Mercury-Avionics/Mercury/README.md

# Mercury
Integrated Avionics Package for Rocket and UAV Needs
Built on STM32 F4
