Mercury-Avionics/Mercury/hardware/parts/Parts-Pricelist.xlsx

Reference Designator | Value | Footprint | Part # (LCSC) | Unit Price | Function / Notes | Reference
C1 | 4.7u | 0805 | C1779 (https://lcsc.com/product-detail/Multilayer-Ceramic-Capacitors-MLCC-SMD-SMT_SAMSUNG_CL21A475KAQNNNE_4-7uF-475-10-25V_C1779.html/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) |  | Bulk Decoupling of STM32 | STM32F407 Datasheet 5.1.6
C2 | 100n | 0402 | C1525 (https://lcsc.com/product-detail/Multilayer-Ceramic-Capacitors-MLCC-SMD-SMT_SAMSUNG_CL05B104KO5NNNC_100nF-104-10-16V_C1525.html/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) |  | Bulk Decoupling of STM32 | STM32F407 Datasheet 5.1.6
C3 | 100n | 0402 | C1525 (https://lcsc.com/product-detail/Multilayer-Ceramic-Capacitors-MLCC-SMD-SMT_SAMSUNG_CL05B104KO5NNNC_100nF-104-10-16V_C1525.html/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) |  | Bulk Decoupling of STM32 | STM32F407 Datasheet 5.1.6
C4 | 100n | 0402 | C1525 |  | Bulk Decoupling of STM32 | STM32F407 Datasheet 5.1.6
C5 | 100n | 0402 | C1525 |  | Bulk Decoupling of STM32 | STM32F407 Datasheet 5.1.6
C6 | 100n | 0402 | C1525 |  | Bulk Decoupling of STM32 | STM32F407 Datasheet 5.1.6
C7 | 100n | 0402 | C1525 |  | Bulk Decoupling of STM32 | STM32F407 Datasheet 5.1.6
C8 | 100n | 0402 | C1525 |  | Bulk Decoupling of STM32 | STM32F407 Datasheet 5.1.6
C9 | 1u | 0402 | C52923 (https://lcsc.com/product-detail/Multilayer-Ceramic-Capacitors-MLCC-SMD-SMT_SAMSUNG_CL05A105KA5NQNC_1uF-105-10-25V_C52923.html/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) |  | VDDA Analog Filtering | LTSpice
C10 | 10n | 0402 | C15195 (https://lcsc.com/product-detail/Multilayer-Ceramic-Capacitors-MLCC-SMD-SMT_SAMSUNG_CL05B103KB5NNNC_10nF-103-10-50V_C15195.html/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) |  | VDDA Analog Filtering | LTSpice
C11 | 2.2u | 0603 | C23630 (https://lcsc.com/product-detail/Multilayer-Ceramic-Capacitors-MLCC-SMD-SMT_SAMSUNG_CL10A225KO8NNNC_2-2uF-225-10-16V_C23630.html/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) |  | Stabilization of main internal regulator | STM32F407 Datasheet 5.3.2
C12 | 2.2u | 0603 | C23630 (https://lcsc.com/product-detail/Multilayer-Ceramic-Capacitors-MLCC-SMD-SMT_SAMSUNG_CL10A225KO8NNNC_2-2uF-225-10-16V_C23630.html/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) |  | Stabilization of main internal regulator | STM32F407 Datasheet 5.3.2
C13 | 12p | 0402 | C1547 (https://lcsc.com/product-detail/Multilayer-Ceramic-Capacitors-MLCC-SMD-SMT_12pF-120-5-50V_C1547.html/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) |  | Crystal Load Capacitance | HSE 16MHz Datasheet
C14 | 12p | 0402 | C1547 (https://lcsc.com/product-detail/Multilayer-Ceramic-Capacitors-MLCC-SMD-SMT_12pF-120-5-50V_C1547.html/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) |  | Crystal Load Capacitance | HSE 16MHz Datasheet
C15 | 22u | 0805 | C45783 (https://lcsc.com/product-detail/Multilayer-Ceramic-Capacitors-MLCC-SMD-SMT_SAMSUNG_CL21A226MAQNNNE_22uF-226-20-25V_C45783.html/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) |  | Voltage Regulator I/O decoupling | AMS1117 Datasheet
C16 | 22u | 0805 | C45783 (https://lcsc.com/product-detail/Multilayer-Ceramic-Capacitors-MLCC-SMD-SMT_SAMSUNG_CL21A226MAQNNNE_22uF-226-20-25V_C45783.html/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) |  | Voltage Regulator I/O decoupling | AMS1117 Datasheet
C17 | 22u | 0805 | C45783 (https://lcsc.com/product-detail/Multilayer-Ceramic-Capacitors-MLCC-SMD-SMT_SAMSUNG_CL21A226MAQNNNE_22uF-226-20-25V_C45783.html/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) |  | Voltage Regulator I/O decoupling | AMS1117 Datasheet
C18 | 22u | 0805 | C45783 (https://lcsc.com/product-detail/Multilayer-Ceramic-Capacitors-MLCC-SMD-SMT_SAMSUNG_CL21A226MAQNNNE_22uF-226-20-25V_C45783.html/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) |  | Voltage Regulator I/O decoupling | AMS1117 Datasheet
C19 | 100n | 0402 | C1525 (https://lcsc.com/product-detail/Multilayer-Ceramic-Capacitors-MLCC-SMD-SMT_SAMSUNG_CL05B104KO5NNNC_100nF-104-10-16V_C1525.html/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) |  | IMU Decoupling | MPU-6050 Datasheet 7.3
C20 | 100n | 0402 | C1525 (https://lcsc.com/product-detail/Multilayer-Ceramic-Capacitors-MLCC-SMD-SMT_SAMSUNG_CL05B104KO5NNNC_100nF-104-10-16V_C1525.html/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) |  | IMU Decoupling | MPU-6050 Datasheet 7.3
C21 | 100n | 0402 | C1525 (https://lcsc.com/product-detail/Multilayer-Ceramic-Capacitors-MLCC-SMD-SMT_SAMSUNG_CL05B104KO5NNNC_100nF-104-10-16V_C1525.html/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) |  | Regulator Filter Capacitor | MPU-6050 Datasheet 7.3
C22 | 2.2n | 0603 | C1604 (https://lcsc.com/product-detail/Multilayer-Ceramic-Capacitors-MLCC-SMD-SMT_2-2nF-222-10-50V_C1604.html/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) |  | Charge Pump Capacitor | MPU-6050 Datasheet 7.3
C23 | 100n | 0402 | C1525 (https://lcsc.com/product-detail/Multilayer-Ceramic-Capacitors-MLCC-SMD-SMT_SAMSUNG_CL05B104KO5NNNC_100nF-104-10-16V_C1525.html/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) |  | Decoupling capacitor | Estimate
C24 | 100n | 0402 | C1525 (https://lcsc.com/product-detail/Multilayer-Ceramic-Capacitors-MLCC-SMD-SMT_SAMSUNG_CL05B104KO5NNNC_100nF-104-10-16V_C1525.html/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) |  | Decoupling capacitor | MPL3115A2 Datasheet
C25 | 10u | 0805 | C15850 (https://lcsc.com/product-detail/Multilayer-Ceramic-Capacitors-MLCC-SMD-SMT_SAMSUNG_CL21A106KAYNNNE_10uF-106-10-25V_C15850.html/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) |  | Decoupling capacitor | MPL3115A2 Datasheet
C26 | 100n | 0402 | C1525 (https://lcsc.com/product-detail/Multilayer-Ceramic-Capacitors-MLCC-SMD-SMT_SAMSUNG_CL05B104KO5NNNC_100nF-104-10-16V_C1525.html/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) |  | Decoupling capacitor | MPL3115A2 Datasheet
C27 | 100n | 0402 | C1525 (https://lcsc.com/product-detail/Multilayer-Ceramic-Capacitors-MLCC-SMD-SMT_SAMSUNG_CL05B104KO5NNNC_100nF-104-10-16V_C1525.html/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) |  | Decoupling capacitor | CC2500 Reference Schematic
C28 | 100n | 0402 | C1525 (https://lcsc.com/product-detail/Multilayer-Ceramic-Capacitors-MLCC-SMD-SMT_SAMSUNG_CL05B104KO5NNNC_100nF-104-10-16V_C1525.html/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) |  | Decoupling capacitor | CC2500 Reference Schematic
C29 | 100n | 0402 | C1525 (https://lcsc.com/product-detail/Multilayer-Ceramic-Capacitors-MLCC-SMD-SMT_SAMSUNG_CL05B104KO5NNNC_100nF-104-10-16V_C1525.html/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) |  | Decoupling capacitor | CC2500 Reference Schematic
C30 | 220p | 0402 | C1530 (https://lcsc.com/product-detail/Multilayer-Ceramic-Capacitors-MLCC-SMD-SMT_220pF-221-10-50V_C1530.html/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) |  | Decoupling capacitor | CC2500 Reference Schematic
C31 | 220p | 0402 | C1530 (https://lcsc.com/product-detail/Multilayer-Ceramic-Capacitors-MLCC-SMD-SMT_220pF-221-10-50V_C1530.html/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) |  | Decoupling capacitor | CC2500 Reference Schematic
C32 | 220p | 0402 | C1530 (https://lcsc.com/product-detail/Multilayer-Ceramic-Capacitors-MLCC-SMD-SMT_220pF-221-10-50V_C1530.html/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) |  | Decoupling capacitor | CC2500 Reference Schematic
C33 | 100n | 0402 | C1525 (https://lcsc.com/product-detail/Multilayer-Ceramic-Capacitors-MLCC-SMD-SMT_SAMSUNG_CL05B104KO5NNNC_100nF-104-10-16V_C1525.html/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) |  | Decoupling capacitor | CC2500 Reference Schematic
C34 | 12p | 0402 | C1547 (https://lcsc.com/product-detail/Multilayer-Ceramic-Capacitors-MLCC-SMD-SMT_12pF-120-5-50V_C1547.html/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) |  | Crystal Load Capacitance | HSE 26MHz Datasheet
C35 | 12p | 0402 | C1547 (https://lcsc.com/product-detail/Multilayer-Ceramic-Capacitors-MLCC-SMD-SMT_12pF-120-5-50V_C1547.html/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) |  | Crystal Load Capacitance | HSE 26MHz Datasheet
C36 | 1n | 0402 | C1523 (https://lcsc.com/product-detail/Multilayer-Ceramic-Capacitors-MLCC-SMD-SMT_1nF-102-10-50V_C1523.html/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) |  | Decoupling capacitor | CC2592 Reference Design
C37 | 12p | 0402 | C1547 (https://lcsc.com/product-detail/Multilayer-Ceramic-Capacitors-MLCC-SMD-SMT_12pF-120-5-50V_C1547.html/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) |  | Decoupling capacitor | CC2592 Reference Design
C38 | 1u | 0402 | C52923 (https://lcsc.com/product-detail/Multilayer-Ceramic-Capacitors-MLCC-SMD-SMT_SAMSUNG_CL05A105KA5NQNC_1uF-105-10-25V_C52923.html/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) |  | Decoupling capacitor | CC2592 Reference Design
C39 | 1n | 0402 | C1523 (https://lcsc.com/product-detail/Multilayer-Ceramic-Capacitors-MLCC-SMD-SMT_1nF-102-10-50V_C1523.html/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) |  | Decoupling capacitor | CC2592 Reference Design
C40 | 12p | 0402 | C1547 (https://lcsc.com/product-detail/Multilayer-Ceramic-Capacitors-MLCC-SMD-SMT_12pF-120-5-50V_C1547.html/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) |  | Decoupling capacitor | CC2592 Reference Design
C41 | 2.2p | 0402 | C1559 (https://lcsc.com/product-detail/Multilayer-Ceramic-Capacitors-MLCC-SMD-SMT_2-2pF-2R2-0-25pF-50V_C1559.html/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) |  | Impedance matching | CC2592 Reference Design
C43 | 0.1p | 0402 | C161338 (https://lcsc.com/product-detail/Multilayer-Ceramic-Capacitors-MLCC-SMD-SMT_Murata-Electronics-GJM1555C1HR10WB01D_C161338.html/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) |  | Impedance matching | CC2592 Reference Design
C44 | 18p | 0402 | C1549 (https://lcsc.com/product-detail/Multilayer-Ceramic-Capacitors-MLCC-SMD-SMT_18pF-180-5-50V_C1549.html/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) |  | DC block capacitor | CC2592 Reference Design
C45 | 1u | 0402 | C52923 (https://lcsc.com/product-detail/Multilayer-Ceramic-Capacitors-MLCC-SMD-SMT_SAMSUNG_CL05A105KA5NQNC_1uF-105-10-25V_C52923.html/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) |  | Decoupling capacitor | Max-8Q Reference Design
C46 | 1u | 0402 | C52923 (https://lcsc.com/product-detail/Multilayer-Ceramic-Capacitors-MLCC-SMD-SMT_SAMSUNG_CL05A105KA5NQNC_1uF-105-10-25V_C52923.html/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) |  | Decoupling capacitor | Max-8Q Reference Design
C47 | 47p | 0402 | C1567 (https://lcsc.com/product-detail/Multilayer-Ceramic-Capacitors-MLCC-SMD-SMT_47pF-470-5-50V_C1567.html/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) |  | Antenna match | Max-8Q Reference Design
C48 | 10n | 0402 | C27147 (https://lcsc.com/product-detail/HF-Inductors_Sunlord-SDCL1005C10NJTDF_C27147.html/?href=jlc-SMT) |  | Antenna match | Max-8Q Reference Design
D1 | Green LED | 0603 | C72043 (https://lcsc.com/product-detail/Light-Emitting-Diodes-LED_0603-Green-light_C72043.html/?href=jlc-SMT) |  | Status LED | n/a
D2 | Red LED | 0603 | C2286 (https://lcsc.com/product-detail/Light-Emitting-Diodes-LED_Hubei-KENTO-Elec-KT-0603R_C2286.html/?href=jlc-SMT) |  | 3.3V LED | n/a
D3 | Orange LED | 0603 | C375450 (https://lcsc.com/product-detail/Light-Emitting-Diodes-LED_EKINGLUX-E6C0603SEAC1UDA_C375450.html/?href=jlc-SMT) |  | 5v LED | n/a
J1 | SWD | -- | Digikey (https://www.digikey.com/en/products/detail/sullins-connector-solutions/GRPB052VWVN-RC/1786455) |  | SWD connector | n/a
J2 | Wire Connector | -- | n/a |  | n/a | n/a
J3 | Wire Connector | -- | n/a |  | n/a | n/a
J4 | Wire Connector | -- | n/a |  | n/a | n/a
J5 | Wire Connector | -- | n/a |  | n/a | n/a
J6 | Wire Connector | -- | n/a |  | n/a | n/a
J7 | 629105150521 | -- | Digikey (https://www.digikey.com/en/products/detail/w%C3%BCrth-elektronik/629105150521/5047751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) |  | n/a | n/a
J8 | 1x2 screw terminal | -- | Digikey (https://www.digikey.com/en/products/detail/cui-devices/TB010-508-02BE/10064142) |  | Screw Terminal | n/a
J9 | 1x3 screw terminal | -- | Digikey (https://www.digikey.com/en/products/detail/cui-devices/TB009-508-03BE/10064152) |  | Screw Terminal | n/a
J10 | 1x3 screw terminal | -- | Digikey (https://www.digikey.com/en/products/detail/cui-devices/TB009-508-03BE/10064152) |  | Screw Terminal | n/a
J11 | 1x2 screw terminal | -- | Digikey (https://www.digikey.com/en/products/detail/cui-devices/TB010-508-02BE/10064142) |  | Screw Terminal | n/a
J12 | 1x2 screw terminal | -- | Digikey (https://www.digikey.com/en/products/detail/cui-devices/TB010-508-02BE/10064142) |  | Screw Terminal | n/a
L1 | 39n | 0402 | C26443 (https://lcsc.com/product-detail/HF-Inductors_Sunlord-SDCL1005C39NJTDF_C26443.html/?href=jlc-SMT) |  | VDDA Analog Filtering | n/a
L2 | 4.7n | 0402 | C13595 (https://lcsc.com/product-detail/HF-Inductors_Sunlord-SDCL1005C4N7STDF_C13595.html/?href=jlc-SMT) |  | Antenna match | CC2592 Reference Design
L3 | 1n | 0402 | C18222 (https://lcsc.com/product-detail/HF-Inductors_Murata-Electronics_LQG15HS1N0S02D_Murata-Electronics-LQG15HS1N0S02D_C18222.html/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) |  | Antenna match | CC2592 Reference Design
L4 | 1.8n | 0402 | C18304 (https://lcsc.com/product-detail/HF-Inductors_Sunlord-SDCL1005C1N8STDF_C18304.html/?href=jlc-SMT) |  | Antenna match | CC2592 Reference Design
L5 | 27n | 0402 | C12100 (https://lcsc.com/product-detail/HF-Inductors_Sunlord-SDCL1608C27NJTDF_C12100.html/?href=jlc-SMT) |  | Antenna match | Max-8Q Reference Design
Q1 | PMOS | -- | C15127 (https://lcsc.com/product-detail/MOSFET_Alpha-Omega-Semicon_AO3401A_Alpha-Omega-Semicon-AOS-AO3401A_C15127.html/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) |  | Reverse Polarity Protection | n/a
R1 | 10k | 0402 | C25744 (https://lcsc.com/product-detail/Chip-Resistor-Surface-Mount_Uniroyal-Elec-0402WGF1002TCE_C25744.html/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) |  | Pullup/Down | n/a
R2 | 47 | 0805 | C17714 (https://lcsc.com/product-detail/Chip-Resistor-Surface-Mount_Uniroyal-Elec-0805W8F470JT5E_C17714.html/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) |  | Crystal Feed Resistor | n/a
R3 | 1k | 0402 | C11702 (https://lcsc.com/product-detail/Chip-Resistor-Surface-Mount_Uniroyal-Elec-0402WGF1001TCE_C11702.html/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) |  | Current Limiting Resistor | n/a
R4 | 22 | 0402 | C25092 (https://lcsc.com/product-detail/Chip-Resistor-Surface-Mount_Uniroyal-Elec-0402WGF220JTCE_C25092.html/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) |  | Current Limiting Resistor | n/a
R5 | 22 | 0402 | C25092 (https://lcsc.com/product-detail/Chip-Resistor-Surface-Mount_Uniroyal-Elec-0402WGF220JTCE_C25092.html/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) |  | Current Limiting Resistor | n/a
R6 | 22 | 0402 | C25092 (https://lcsc.com/product-detail/Chip-Resistor-Surface-Mount_Uniroyal-Elec-0402WGF220JTCE_C25092.html/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) |  | Current Limiting Resistor | n/a
R7 | 22 | 0402 | C25092 (https://lcsc.com/product-detail/Chip-Resistor-Surface-Mount_Uniroyal-Elec-0402WGF220JTCE_C25092.html/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) |  | Current Limiting Resistor | n/a
R8 | 22 | 0402 | C25092 (https://lcsc.com/product-detail/Chip-Resistor-Surface-Mount_Uniroyal-Elec-0402WGF220JTCE_C25092.html/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) |  | Current Limiting Resistor | n/a
R9 | 22 | 0402 | C25092 (https://lcsc.com/product-detail/Chip-Resistor-Surface-Mount_Uniroyal-Elec-0402WGF220JTCE_C25092.html/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) |  | Current Limiting Resistor | n/a
R10 | 22 | 0402 | C25092 (https://lcsc.com/product-detail/Chip-Resistor-Surface-Mount_Uniroyal-Elec-0402WGF220JTCE_C25092.html/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) |  | Current Limiting Resistor | n/a
R11 | 22 | 0402 | C25092 (https://lcsc.com/product-detail/Chip-Resistor-Surface-Mount_Uniroyal-Elec-0402WGF220JTCE_C25092.html/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) |  | Current Limiting Resistor | n/a
R12 | 22 | 0402 | C25092 (https://lcsc.com/product-detail/Chip-Resistor-Surface-Mount_Uniroyal-Elec-0402WGF220JTCE_C25092.html/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) |  | Current Limiting Resistor | n/a
R13 | 22 | 0402 | C25092 (https://lcsc.com/product-detail/Chip-Resistor-Surface-Mount_Uniroyal-Elec-0402WGF220JTCE_C25092.html/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) |  | Current Limiting Resistor | n/a
R14 | 22 | 0402 | C25092 (https://lcsc.com/product-detail/Chip-Resistor-Surface-Mount_Uniroyal-Elec-0402WGF220JTCE_C25092.html/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) |  | Current Limiting Resistor | n/a
R15 | 22 | 0402 | C25092 (https://lcsc.com/product-detail/Chip-Resistor-Surface-Mount_Uniroyal-Elec-0402WGF220JTCE_C25092.html/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) |  | Current Limiting Resistor | n/a
R16 | 22 | 0402 | C25092 (https://lcsc.com/product-detail/Chip-Resistor-Surface-Mount_Uniroyal-Elec-0402WGF220JTCE_C25092.html/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) |  | Current Limiting Resistor | n/a
R17 | 22 | 0402 | C25092 (https://lcsc.com/product-detail/Chip-Resistor-Surface-Mount_Uniroyal-Elec-0402WGF220JTCE_C25092.html/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) |  | Current Limiting Resistor | n/a
R18 | 22 | 0402 | C25092 (https://lcsc.com/product-detail/Chip-Resistor-Surface-Mount_Uniroyal-Elec-0402WGF220JTCE_C25092.html/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) |  | Current Limiting Resistor | n/a
R19 | 22 | 0402 | C25092 (https://lcsc.com/product-detail/Chip-Resistor-Surface-Mount_Uniroyal-Elec-0402WGF220JTCE_C25092.html/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) |  | Current Limiting Resistor | n/a
R20 | 22 | 0402 | C25092 (https://lcsc.com/product-detail/Chip-Resistor-Surface-Mount_Uniroyal-Elec-0402WGF220JTCE_C25092.html/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) |  | Current Limiting Resistor | n/a
R21 | 22 | 0402 | C25092 (https://lcsc.com/product-detail/Chip-Resistor-Surface-Mount_Uniroyal-Elec-0402WGF220JTCE_C25092.html/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) |  | Current Limiting Resistor | n/a
R22 | 22 | 0402 | C25092 (https://lcsc.com/product-detail/Chip-Resistor-Surface-Mount_Uniroyal-Elec-0402WGF220JTCE_C25092.html/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) |  | Current Limiting Resistor | n/a
R23 | 22 | 0402 | C25092 (https://lcsc.com/product-detail/Chip-Resistor-Surface-Mount_Uniroyal-Elec-0402WGF220JTCE_C25092.html/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) |  | Current Limiting Resistor | n/a
R24 | 22 | 0402 | C25092 (https://lcsc.com/product-detail/Chip-Resistor-Surface-Mount_Uniroyal-Elec-0402WGF220JTCE_C25092.html/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) |  | Current Limiting Resistor | n/a
R25 | 22 | 0402 | C25092 (https://lcsc.com/product-detail/Chip-Resistor-Surface-Mount_Uniroyal-Elec-0402WGF220JTCE_C25092.html/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) |  | Current Limiting Resistor | n/a
R26 | 4k7 | 0402 | C25900 (https://lcsc.com/product-detail/Chip-Resistor-Surface-Mount_Uniroyal-Elec-0402WGF4701TCE_C25900.html/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) |  | Pullup | n/a
R27 | 4k7 | 0402 | C25900 (https://lcsc.com/product-detail/Chip-Resistor-Surface-Mount_Uniroyal-Elec-0402WGF4701TCE_C25900.html/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) |  | Pullup | n/a
R28 | 4k7 | 0402 | C25900 |  | Pullup | n/a
R29 | 4k7 | 0402 | C25900 |  | Pullup | n/a
R30 | 1k | 0402 | C11702 (https://lcsc.com/product-detail/Chip-Resistor-Surface-Mount_Uniroyal-Elec-0402WGF1001TCE_C11702.html/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) |  | Current Limiting Resistor | n/a
R31 | 4k7 | 0402 | C25900 (https://lcsc.com/product-detail/Chip-Resistor-Surface-Mount_Uniroyal-Elec-0402WGF4701TCE_C25900.html/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) |  | Pullup | n/a
R32 | 4k7 | 0402 | C25900 (https://lcsc.com/product-detail/Chip-Resistor-Surface-Mount_Uniroyal-Elec-0402WGF4701TCE_C25900.html/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) |  | Pullup | n/a
R33 | 4k7 | 0402 | C25900 |  | Pullup | n/a
R34 | 56k | 0402 | C25796 (https://lcsc.com/product-detail/Chip-Resistor-Surface-Mount_Uniroyal-Elec-0402WGF5602TCE_C25796.html/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) |  | Bias Resistor | CC2500 Reference Schematic
R35 | 47 | 0402 | C25118 (https://lcsc.com/product-detail/Chip-Resistor-Surface-Mount_Uniroyal-Elec-0402WGF470JTCE_C25118.html/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) |  | Crystal Feed Resistor | n/a
R36 | 3k9 | 0402 | C51721 (https://lcsc.com/product-detail/Chip-Resistor-Surface-Mount_Uniroyal-Elec-0402WGF3901TCE_C51721.html/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) |  | Bias Resistor | CC2592 Reference Design
R37 | 10 | 0402 | C25744 (https://lcsc.com/product-detail/Chip-Resistor-Surface-Mount_Uniroyal-Elec-0402WGF1002TCE_C25744.html/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) |  | Pullup | Max-8Q Reference Design
SW1 | SPDT | n/a | Digikey (https://www.digikey.ca/en/products/detail/c-k/OS102011MS2QN1/411602) |  | Boot0 Switch | STM32 Reference
U1 | F407 | QFP-100 | C12345 (https://lcsc.com/product-detail/ST-Microelectronics_STMicroelectronics_STM32F407VGT6_STM32F407VGT6_C12345.html/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) |  | MCU | n/a
U2 | 3.3 | SOT-223 | C6186 (https://lcsc.com/product-detail/Low-Dropout-Regulators-LDO_AMS_AMS1117-3-3_AMS1117-3-3_C6186.html/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) |  | 3.3v | AMS1117 Datasheet
U3 | 5.0 | SOT-223 | C6187 (https://lcsc.com/product-detail/Low-Dropout-Regulators-LDO_AMS_AMS1117-5-0_AMS1117-5-0_C6187.html/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) |  | 5.0v | AMS1117 Datasheet
U4 | MPU-6050 | QFN-24 | C24112 (https://lcsc.com/product-detail/Attitude-Sensors_TDK-InvenSense_MPU-6050_TDK-InvenSense-MPU-6050_C24112.html/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) |  | IMU | MPU-6050 Datasheet
U5 | Flash | WSON-8_EP_6.0x8.0x1.27P | C88868 (https://lcsc.com/product-detail/FLASH_Winbond-Elec-W25N01GVZEIG_C88868.html/?href=jlc-SMT) |  |  | n/a
U6 | Altimeter | LGA-8 | Digikey (https://www.digikey.com/en/products/detail/nxp-usa-inc/MPL3115A2R1/3873800) |  | Altimeter | n/a | C54429 (https://lcsc.com/product-detail/Sensors_FREESCALE_MPL3115A2R1_MPL3115A2R1_C54429.html/?href=jlc-SMT)
U7 | RF Transciever | QFN-20 | Digikey (https://www.digikey.com/en/products/detail/texas-instruments/CC2500RGP/998341) |  | Transciever | n/a | C57494 (https://lcsc.com/product-detail/RF-Chips_Texas-Instruments_CC2500RGPR_Texas-Instruments-TI-CC2500RGPR_C57494.html/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)
U8 | RF PA | QFN-16 | C53274 (https://lcsc.com/product-detail/RF-Transceiver-ICs_Texas-Instruments_CC2592RGVR_Texas-Instruments-TI-CC2592RGVR_C53274.html/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) |  | RF amplifier | n/a
U9 | GPS reciever | SMD-18 | Digikey (https://www.digikey.com/en/products/detail/u-blox/MAX-8Q-0/9818026) |  | GPS | n/a
Y1 | 16 MHz Oscillator | SMD_3225 | C13738 (https://lcsc.com/product-detail/SMD-Crystal-Resonators_Yangxing-Tech-X322516MLB4SI_C13738.html/?href=jlc-SMT) |  | HSE MCU | n/a
Y2 | 26 MHz Oscillator | SMD_3225 | C23425 (https://lcsc.com/product-detail/SMD-Crystal-Resonators_Yangxing-Tech-X322526MEB4SC_C23425.html/?href=jlc-SMT) |  | RF HSE | n/a
 |  |  |  |  |  | n/a
