Mercury-Avionics/Mercury/hardware/parts/Selected ICs.xlsx

Designator | MFR. Part # | Manufacturer | Section | Footprint | LCSC Part #（optional） | Comment
 | STM32F407VGT6 | STMicroelectronics | MCU | LQFP-100_14.0x14.0x0.5P | C12345 | Main MCU
 | LPS25HBTR | STMicroelectronics | Sensors | HLGA-10L | C87898 (https://lcsc.com/product-detail/Pressure-Sensors_STMicroelectronics-LPS25HBTR_C87898.html/?href=jlc-SMT) | Altimeter
 | MPU-6050 | TDK InvenSense | Sensors | QFN-24_4x4x05P | C24112 | IMU
 | CC2500 | Texas Instruments | RF | QFN-20_4x4x05P | C57494 | RF Transceiver
 | CC2591 | Texas Instruments | RF | QFN-16_4x4x065P | C17205 | RF Front End
 | AMS1117-3.3 | Advanced Monolithic Systems | Power | SOT-223 | C6186 | Power Delivery - 3.3V
 | AMS1117-5.0 | Advanced Monolithic Systems | Power | SOT-223 | C6187 | Power Delivery - 5.0V
 | TE Connectivity 5-1814832-2 | TE Connectivity | RF | - | C482015 | SMA Connector
 | 1981568-1 | TE Connectivity | USB | USB Micro B |  | USB Connector | 1981568-1 (https://www.mouser.com/ProductDetail/TE-Connectivity/1981568-1/?qs=zxTme0yW%2FbaAfvOKTKC5hw%3D%3D)
 | W25N01GVZEIG | Winbond Elec | Storage | WSON-8_EP_6.0x8.0x1.27P | C88868 | 1GB Flash Storage
 | X322516MLB4SI | Yangxing Tech | MCU | SMD-CRY-3225_4P | C13738 | 16 MHz Oscillator
 | 1C/N226000AA0D | KDS Daishinku | RF | SMD-3225_4P | C160424 | 26 MHz Oscillator
