Mercury-Avionics/Mercury/hardware/parts/Parts_not_on_JLC_PCB_LCSC.xlsx

Manufacturer | Part ID/# | Store | Price/Unit | Quantity | URL | Notes
U-Blox | MAX-8Q-0 | Digikey | $21 | 1 | https://www.digikey.com/en/products/detail/u-blox/MAX-8Q-0/9818026 | GPS Transiever
