Mercury-Avionics/Mercury/hardware/kiCad/3D_Models/User Library-MAX-M8 u-blox M8 Concurrent GNSS Module.step

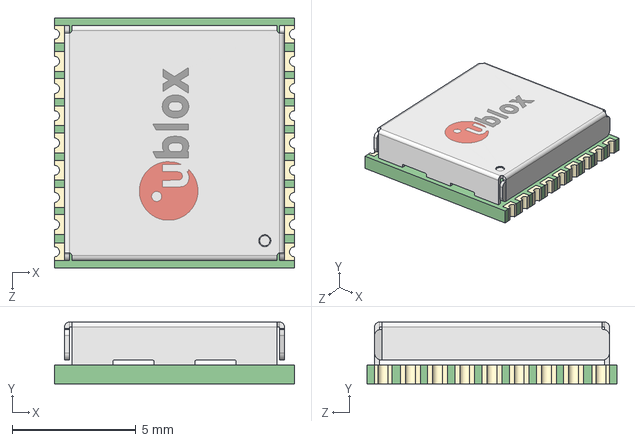
[picture p1: CAD file, 2021-01-06]
hardware/kiCad/3D_Models/User Library-MAX-M8 u-blox M8 Concurrent GNSS Module.step
9.70 x 2.50 x 10.1 mm
