Mercury-Avionics/Mercury/hardware/kiCad/SnapEDA/LPS25HBTR/LPS25HBTR.step

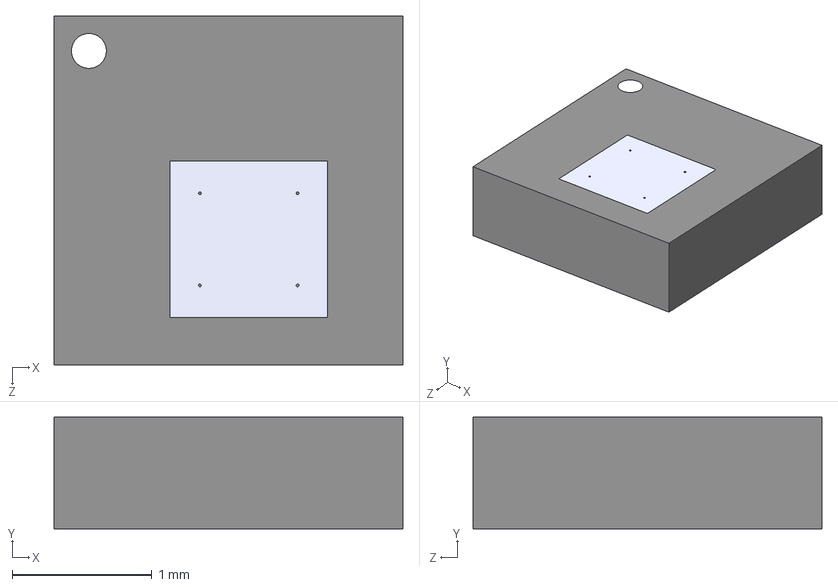
[picture p2: CAD file, 2021-01-06]
hardware/kiCad/SnapEDA/LPS25HBTR/LPS25HBTR.step
2.50 x 0.8 x 2.50 mm
