Mercury-Avionics/Mercury/hardware/kiCad/3D_Models/User Library-sma.step

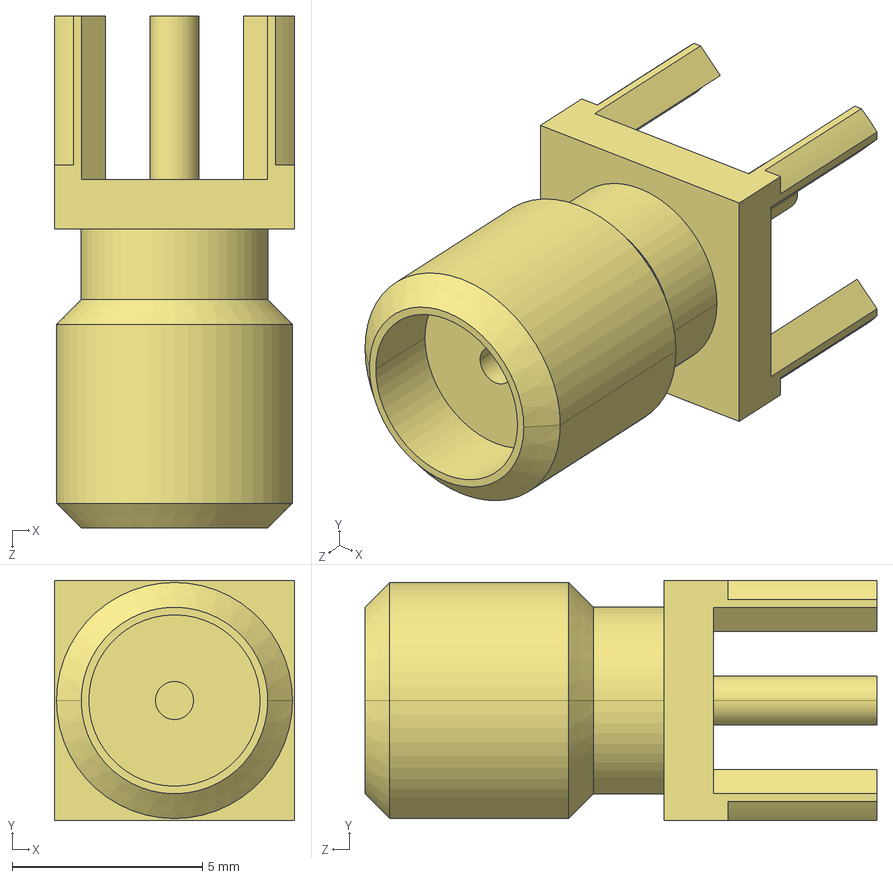
[picture p3: CAD file, 2021-01-06]
hardware/kiCad/3D_Models/User Library-sma.step
6.31 x 6.31 x 13.4 mm
