Mercury-Avionics/Mercury/hardware/kiCad/Mercury/Mercury.kicad_pcb

## KiCad design hardware/kiCad/Mercury/Mercury.kicad_pcb (2021-01-18)

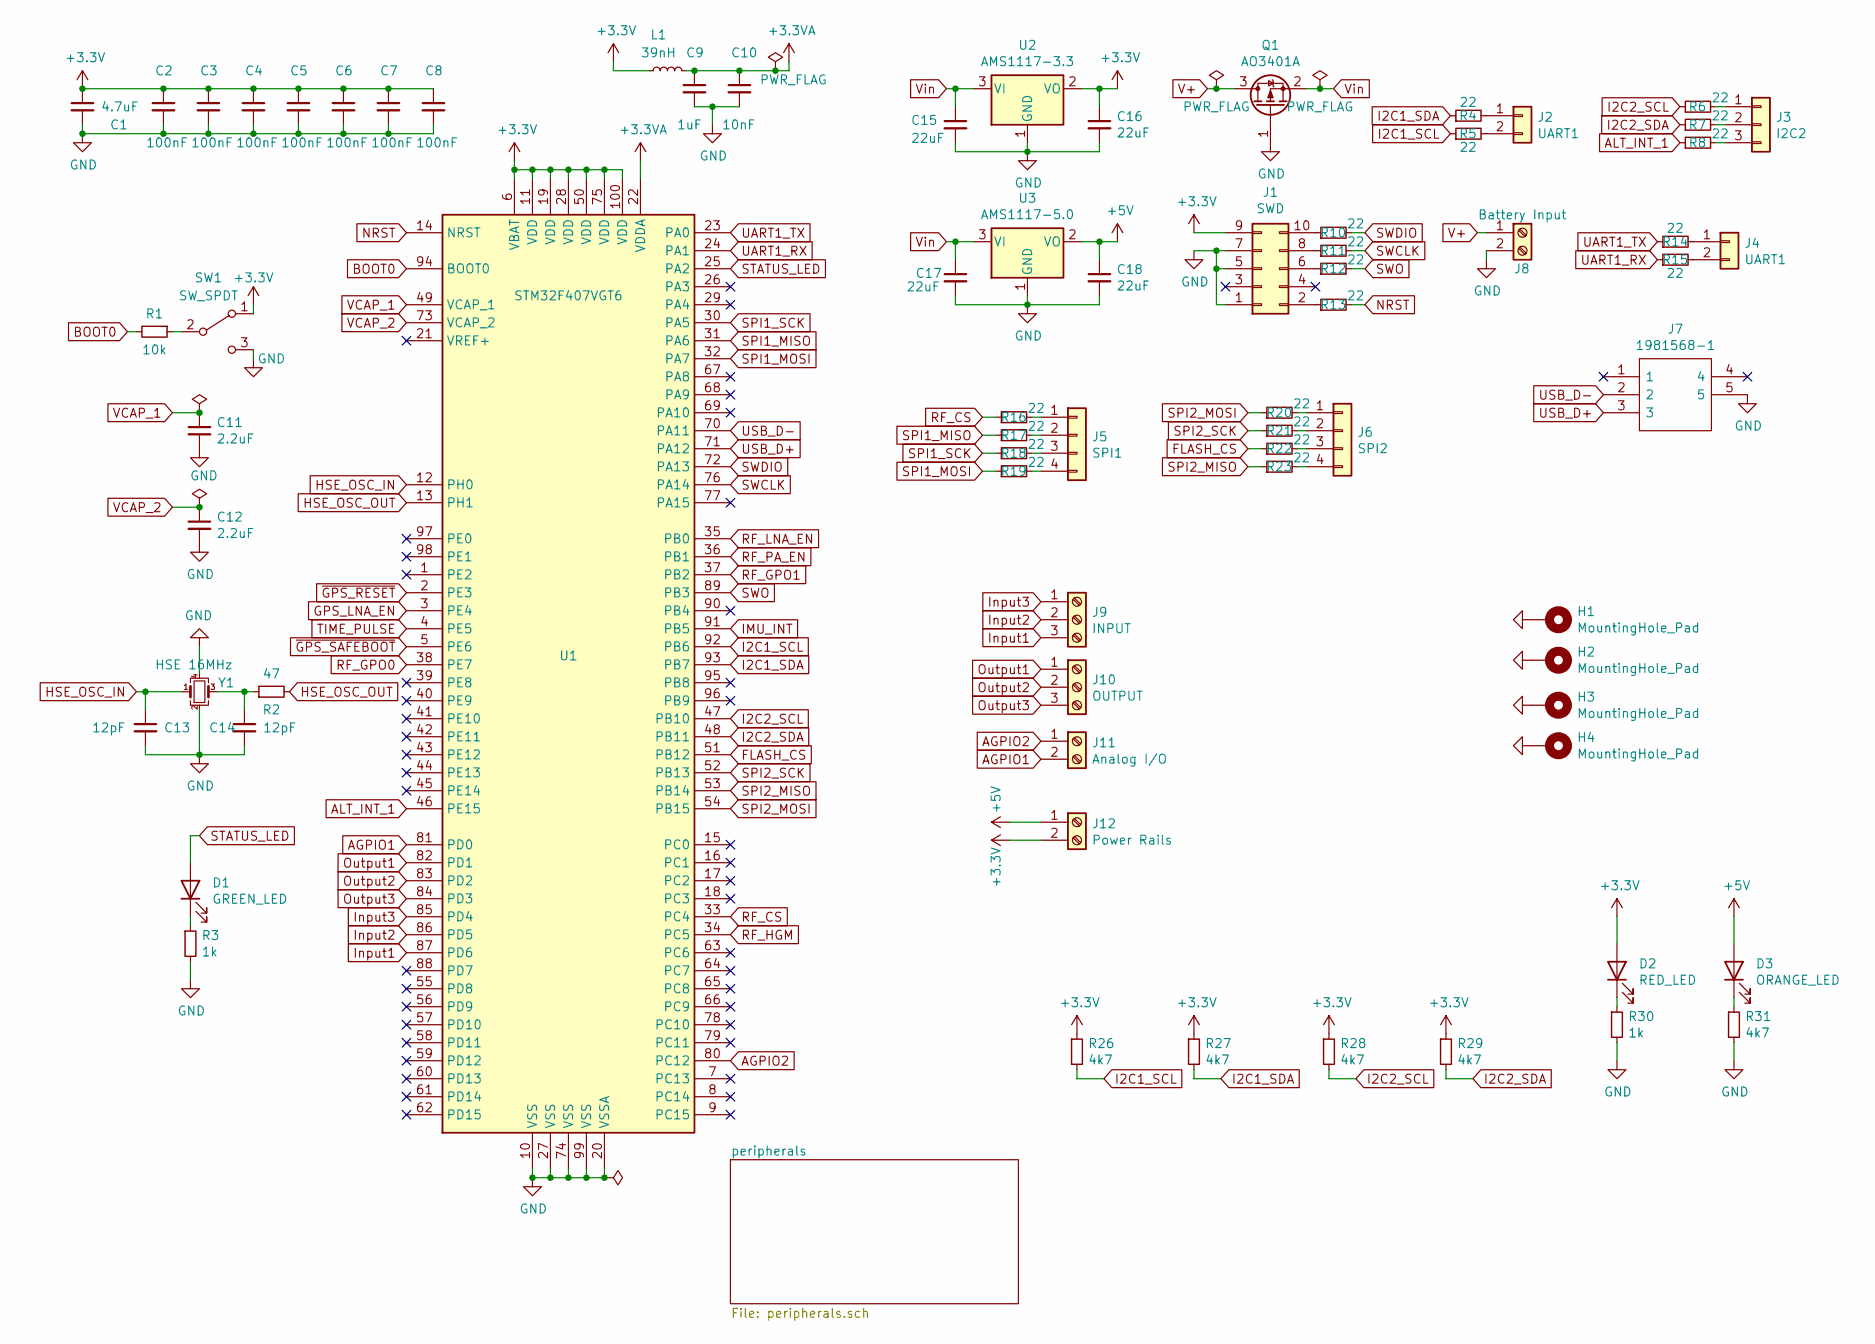
[picture p4: schematic Mercury.sch, Mercury Avionics Package]

Parts:
C1: 4.7uF; C_0805_2012Metric; LCSC Part # C1779
C2, C3, C4, C5, C6, C7, C8: 100nF; C_0402_1005Metric; LCSC Part # C1525
C9: 1uF; C_0402_1005Metric; LCSC Part # C52923
C10: 10nF; C_0402_1005Metric; LCSC Part # C15195
C11, C12: 2.2uF; C_0603_1608Metric; LCSC Part # C23630
C13, C14: 12pF; C_0402_1005Metric; LCSC Part # C1547
C15, C16, C17, C18: 22uF; C_0805_2012Metric; LCSC Part # C45783
D1: GREEN_LED; LED_0603_1608Metric; LCSC Part # C72043
D2: RED_LED; LED_0603_1608Metric; LCSC Part # C2286
D3: ORANGE_LED; LED_0603_1608Metric; LCSC Part # C375450
H1, H2, H3, H4: MountingHole_Pad; MountingHole_3mm_Pad_Via
J1: SWD; PinHeader_2x05_P1.27mm_Vertical
J2, J4: UART1; SolderWire-0.1sqmm_1x02_P3.6mm_D0.4mm_OD1mm
J3: I2C2; SolderWire-0.1sqmm_1x03_P3.6mm_D0.4mm_OD1mm
J5: SPI1; SolderWire-0.1sqmm_1x04_P3.6mm_D0.4mm_OD1mm
J6: SPI2; SolderWire-0.1sqmm_1x04_P3.6mm_D0.4mm_OD1mm
J7: 1981568-1; Mouser Part Number 571-1981568-1
J8: Battery Input; TerminalBlock_Phoenix_MKDS-1,5-2-5.08_1x02_P5.08mm_Horizont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
J9: INPUT; TerminalBlock_Phoenix_MKDS-1,5-3-5.08_1x03_P5.08mm_Horizont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
J10: OUTPUT; TerminalBlock_Phoenix_MKDS-1,5-3-5.08_1x03_P5.08mm_Horizont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
J11: Analog I/O; TerminalBlock_Phoenix_MKDS-1,5-2-5.08_1x02_P5.08mm_Horizont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
J12: Power Rails; TerminalBlock_Phoenix_MKDS-1,5-2-5.08_1x02_P5.08mm_Horizont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
L1: 39nH; L_0402_1005Metric; LCSC Part # C26443
Q1: AO3401A; SOT-23; LCSC Part # C15127
R1: 10k; R_0402_1005Metric; LCSC Part # C25744
R2: 47; R_0805_2012Metric; LCSC Part # C17714
R3, R30: 1k; R_0402_1005Metric; LCSC Part # C11702
R4, R5, R6, R7, R8, R10, R11, R12, R13, R14, R15, R16, R17, R18, R19, R20, R21, R22, R23: 22; R_0402_1005Metric; LCSC Part # C25092
R26, R27, R28, R29, R31: 4k7; R_0402_1005Metric; LCSC Part # C25900
SW1: SW_SPDT; SW_CuK_OS102011MA1QN1_SPDT_Angled
U1: STM32F407VGT6; LQFP-100_14x14mm_P0.5mm; LCSC Part # C12345
U2: AMS1117-3.3; SOT-223-3_TabPin2; LCSC Part # C6186
U3: AMS1117-5.0; SOT-223-3_TabPin2; LCSC Part # C6187
Y1: HSE 16MHz; Crystal_SMD_3225-4Pin_3.2x2.5mm; LCSC Part # C13738

Connections:
+3.3VA: C9.1, C10.1, L1.2, U1.22 (VDDA)
+3V3: C1.1, C2.1, C3.1, C4.1, C5.1, C6.1, C7.1, C8.1, C16.1, D2.2 (A), J1.9, J12.2, L1.1, R26.1, R27.1, R28.1, R29.1, SW1.1 (A), U1.6 (VBAT), U1.11 (VDD), U1.19 (VDD), U1.28 (VDD), U1.50 (VDD), U1.75 (VDD), U1.100 (VDD), U2.2 (VO); also elsewhere on the board
+5V: C18.1, D3.2 (A), J12.1, U3.2 (VO)
AGPIO1: J11.2, U1.81 (PD0)
AGPIO2: J11.1, U1.80 (PC12)
ALT_INT_1: R8.1, U1.46 (PE15); also elsewhere on the board
BOOT0: R1.2, U1.94 (BOOT0)
FLASH_CS: R22.1, U1.51 (PB12); also elsewhere on the board
GND: C1.2, C2.2, C3.2, C4.2, C5.2, C6.2, C7.2, C8.2, C9.2, C10.2, C11.2, C12.2, C13.2, C14.2, C15.2, C16.2, C17.2, C18.2, H1.1, H2.1, H3.1, H4.1, J1.1, J1.5, J1.7, J7.5, J8.2, Q1.1 (G), R3.2, R30.2, R31.2, SW1.3 (C), U1.10 (VSS), U1.20 (VSSA), U1.27 (VSS), U1.74 (VSS), U1.99 (VSS), U2.1 (GND), U3.1 (GND), Y1.2, Y1.4; also elsewhere on the board
GPS_LNA_EN: U1.3 (PE4); also elsewhere on the board
HSE_OSC_IN: C13.1, U1.12 (PH0), Y1.1
HSE_OSC_OUT: R2.2, U1.13 (PH1)
I2C1_SCL: R5.1, R26.2, U1.92 (PB6); also elsewhere on the board
I2C1_SDA: R4.1, R27.2, U1.93 (PB7); also elsewhere on the board
I2C2_SCL: R6.1, R28.2, U1.47 (PB10); also elsewhere on the board
I2C2_SDA: R7.1, R29.2, U1.48 (PB11); also elsewhere on the board
IMU_INT: U1.91 (PB5); also elsewhere on the board
Input1: J9.3, U1.87 (PD6)
Input2: J9.2, U1.86 (PD5)
Input3: J9.1, U1.85 (PD4)
NRST: R13.2, U1.14 (NRST)
unnamed: C14.1, R2.1, Y1.3
unnamed: D1.1 (K), R3.1
unnamed: D2.1 (K), R30.1
unnamed: D3.1 (K), R31.1
unnamed: J1.2, R13.1
unnamed: J1.6, R12.1
unnamed: J1.8, R11.1
unnamed: J1.10, R10.1
unnamed: J2.1, R4.2
unnamed: J2.2, R5.2
unnamed: J3.1, R6.2
unnamed: J3.2, R7.2
unnamed: J3.3, R8.2
unnamed: J4.1, R14.2
unnamed: J4.2, R15.2
unnamed: J5.1, R16.2
unnamed: J5.2, R17.2
unnamed: J5.3, R18.2
unnamed: J5.4, R19.2
unnamed: J6.1, R20.2
unnamed: J6.2, R21.2
unnamed: J6.3, R22.2
unnamed: J6.4, R23.2
unnamed: R1.1, SW1.2 (B)
Output1: J10.1, U1.82 (PD1)
Output2: J10.2, U1.83 (PD2)
Output3: J10.3, U1.84 (PD3)
RF_CS: R16.1, U1.33 (PC4); also elsewhere on the board
RF_GPO0: U1.38 (PE7); also elsewhere on the board
RF_GPO1: U1.37 (PB2); also elsewhere on the board
RF_HGM: U1.34 (PC5); also elsewhere on the board
RF_LNA_EN: U1.35 (PB0); also elsewhere on the board
RF_PA_EN: U1.36 (PB1); also elsewhere on the board
SPI1_MISO: R17.1, U1.31 (PA6); also elsewhere on the board
SPI1_MOSI: R19.1, U1.32 (PA7); also elsewhere on the board
SPI1_SCK: R18.1, U1.30 (PA5); also elsewhere on the board
SPI2_MISO: R23.1, U1.53 (PB14); also elsewhere on the board
SPI2_MOSI: R20.1, U1.54 (PB15); also elsewhere on the board
SPI2_SCK: R21.1, U1.52 (PB13); also elsewhere on the board
STATUS_LED: D1.2 (A), U1.25 (PA2)
SWCLK: R11.2, U1.76 (PA14)
SWDIO: R10.2, U1.72 (PA13)
SWO: R12.2, U1.89 (PB3)
TIME_PULSE: U1.4 (PE5); also elsewhere on the board
UART1_RX: R15.1, U1.24 (PA1); also elsewhere on the board
UART1_TX: R14.1, U1.23 (PA0); also elsewhere on the board
USB_D+: J7.3, U1.71 (PA12)
USB_D-: J7.2, U1.70 (PA11)
V+: J8.1, Q1.3 (D)
VCAP_1: C11.1, U1.49 (VCAP_1)
VCAP_2: C12.1, U1.73 (VCAP_2)
Vin: C15.1, C17.1, Q1.2 (S), U2.3 (VI), U3.3 (VI)
~GPS_RESET: U1.2 (PE3); also elsewhere on the board
~GPS_SAFEBOOT: U1.5 (PE6); also elsewhere on the board

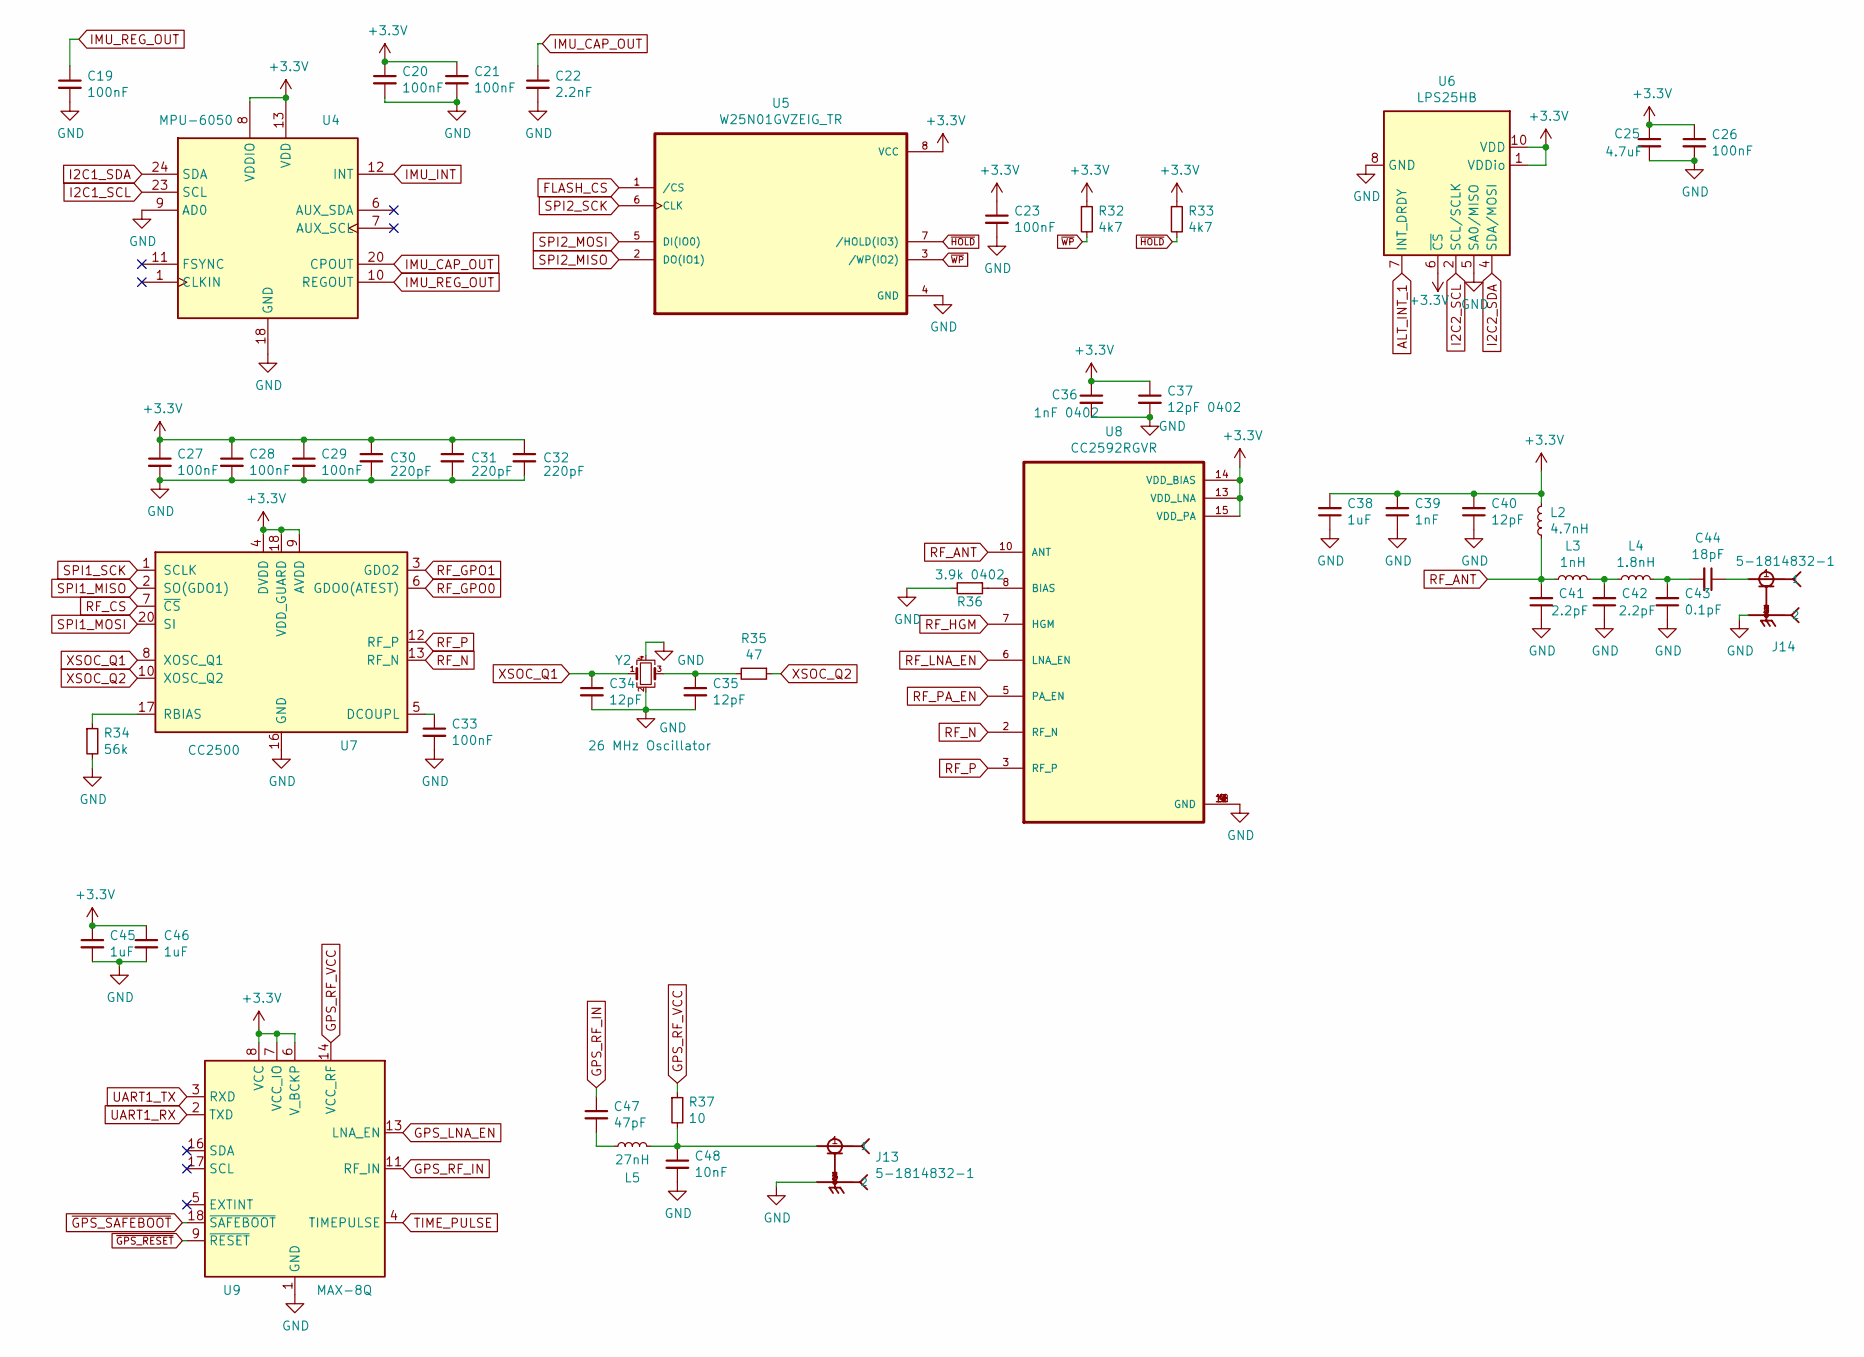
[picture p5: schematic peripherals.sch, Mercury Peripherals]

Parts:
C19, C20, C21, C23, C27, C28, C29, C33: 100nF; C_0402_1005Metric; LCSC Part # C1525
C22: 2.2nF; C_0603_1608Metric; LCSC Part # C1604
C25: 4.7uF; C_0805_2012Metric; LCSC Part # C1779
C26: 100nF; C_0603_1608Metric; LCSC Part # C14663
C30, C31, C32: 220pF; C_0402_1005Metric; LCSC Part # C1530
C34, C35, C40: 12pF; C_0402_1005Metric; LCSC Part # C1547
C36: 1nF 0402; C_0402_1005Metric; LCSC Part # C1523
C37: 12pF 0402; C_0402_1005Metric; LCSC Part # C1547
C38, C45, C46: 1uF; C_0402_1005Metric; LCSC Part # C52923
C39: 1nF; C_0402_1005Metric; LCSC Part # C1523
C41, C42: 2.2pF; C_0402_1005Metric; LCSC Part # C1559
C43: 0.1pF; C_0402_1005Metric; LCSC Part # C161338
C44: 18pF; C_0402_1005Metric; LCSC Part # C1549
C47: 47pF; C_0402_1005Metric; LCSC Part # C1567
C48: 10nF; C_0402_1005Metric; LCSC Part # C15195
J13, J14: 5-1814832-1; TE_5-1814832-1
L2: 4.7nH; L_0402_1005Metric; LCSC Part # C13595
L3: 1nH; L_0402_1005Metric; LCSC Part # C18222
L4: 1.8nH; L_0402_1005Metric; LCSC Part # C18304
L5: 27nH; L_0402_1005Metric; LCSC Part # C18830
R32, R33: 4k7; R_0402_1005Metric; LCSC Part # C25900
R34: 56k; R_0402_1005Metric; LCSC Part # C25796
R35: 47; R_0402_1005Metric; LCSC Part # C25118
R36: 3.9k 0402; R_0402_1005Metric; LCSC Part # C51721
R37: 10; R_0402_1005Metric; LCSC Part # C25744
U4: MPU-6050; InvenSense_QFN-24_4x4mm_P0.5mm; LCSC Part # C24112
U5: W25N01GVZEIG_TR; SON127P800X600X80-9N; LCSC Part # C88868
U6: LPS25HB; ST_HLGA-10_2.5x2.5mm_P0.6mm_LayoutBorder3x2y; LCSC Part # C87898
U7: CC2500; Texas_S-PVQFN-N20_EP2.4x2.4mm; LCSC Part # C57494
U8: CC2592RGVR; QFN65P400X400X100-17N; LCSC Part # C53274
U9: MAX-8Q; ublox_MAX
Y2: 26 MHz Oscillator; Crystal_SMD_3225-4Pin_3.2x2.5mm; LCSC Part # C23425

Connections:
+3V3: C20.1, C21.1, C23.1, C25.1, C26.1, C27.1, C28.1, C29.1, C30.1, C31.1, C32.1, C36.1, C37.1, C38.2, C39.2, C40.2, C45.1, C46.1, L2.2, R32.1, R33.1, U4.8 (VDDIO), U4.13 (VDD), U5.8 (VCC), U6.1 (VDDio), U6.6 (~CS), U6.10 (VDD), U7.4 (DVDD), U7.9 (AVDD), U7.11 (AVDD), U7.14 (AVDD), U7.15 (AVDD), U7.18 (VDD_GUARD), U8.13 (VDD_LNA), U8.14 (VDD_BIAS), U8.15 (VDD_PA), U9.6 (V_BCKP), U9.7 (VCC_IO), U9.8 (VCC); also elsewhere on the board
ALT_INT_1: U6.7 (INT_DRDY); also elsewhere on the board
FLASH_CS: U5.1 (/CS); also elsewhere on the board
GND: C19.2, C20.2, C21.2, C22.2, C23.2, C25.2, C26.2, C27.2, C28.2, C29.2, C30.2, C31.2, C32.2, C33.2, C34.2, C35.2, C36.2, C37.2, C38.1, C39.1, C40.1, C41.1, C42.1, C43.1, C45.2, C46.2, C48.2, J13.2, J13.3 (2), J13.4 (2), J13.5 (2), J14.2, J14.3 (2), J14.4 (2), J14.5 (2), R34.2, R36.2, U4.9 (AD0), U4.18 (GND), U5.4 (GND), U6.3 (GND), U6.5 (SA0/MISO), U6.8 (GND), U6.9 (GND), U7.16 (GND), U7.19 (GND), U7.21 (GND), U8.1 (GND), U8.4 (GND), U8.9 (GND), U8.11 (GND), U8.12 (GND), U8.16 (GND), U9.1 (GND), U9.10 (GND), U9.12 (GND), Y2.2, Y2.4; also elsewhere on the board
GPS_LNA_EN: U9.13 (LNA_EN); also elsewhere on the board
GPS_RF_IN: C47.1, U9.11 (RF_IN)
GPS_RF_VCC: R37.1, U9.14 (VCC_RF)
I2C1_SCL: U4.23 (SCL); also elsewhere on the board
I2C1_SDA: U4.24 (SDA); also elsewhere on the board
I2C2_SCL: U6.2 (SCL/SCLK); also elsewhere on the board
I2C2_SDA: U6.4 (SDA/MOSI); also elsewhere on the board
IMU_CAP_OUT: C22.1, U4.20 (CPOUT)
IMU_INT: U4.12 (INT); also elsewhere on the board
IMU_REG_OUT: C19.1, U4.10 (REGOUT)
unnamed: C33.1, U7.5 (DCOUPL)
unnamed: C35.1, R35.2, Y2.3
unnamed: C42.2, L3.2, L4.1
unnamed: C43.2, C44.2, L4.2
unnamed: C44.1, J14.1
unnamed: C47.2, L5.1
unnamed: C48.1, J13.1, L5.2, R37.2
unnamed: R34.1, U7.17 (RBIAS)
unnamed: R36.1, U8.8 (BIAS)
RF_ANT: C41.2, L2.1, L3.1, U8.10 (ANT)
RF_CS: U7.7 (~CS~); also elsewhere on the board
RF_GPO0: U7.6 (GDO0(ATEST)); also elsewhere on the board
RF_GPO1: U7.3 (GDO2); also elsewhere on the board
RF_HGM: U8.7 (HGM); also elsewhere on the board
RF_LNA_EN: U8.6 (LNA_EN); also elsewhere on the board
RF_N: U7.13 (RF_N), U8.2 (RF_N)
RF_P: U7.12 (RF_P), U8.3 (RF_P)
RF_PA_EN: U8.5 (PA_EN); also elsewhere on the board
SPI1_MISO: U7.2 (SO(GDO1)); also elsewhere on the board
SPI1_MOSI: U7.20 (SI); also elsewhere on the board
SPI1_SCK: U7.1 (SCLK); also elsewhere on the board
SPI2_MISO: U5.2 (DO(IO1)); also elsewhere on the board
SPI2_MOSI: U5.5 (DI(IO0)); also elsewhere on the board
SPI2_SCK: U5.6 (CLK); also elsewhere on the board
TIME_PULSE: U9.4 (TIMEPULSE); also elsewhere on the board
UART1_RX: U9.2 (TXD); also elsewhere on the board
UART1_TX: U9.3 (RXD); also elsewhere on the board
XSOC_Q1: C34.1, U7.8 (XOSC_Q1), Y2.1
XSOC_Q2: R35.1, U7.10 (XOSC_Q2)
~GPS_RESET: U9.9 (~RESET); also elsewhere on the board
~GPS_SAFEBOOT: U9.18 (~SAFEBOOT); also elsewhere on the board
~HOLD: R33.2, U5.7 (/HOLD(IO3))
~WP: R32.2, U5.3 (/WP(IO2))

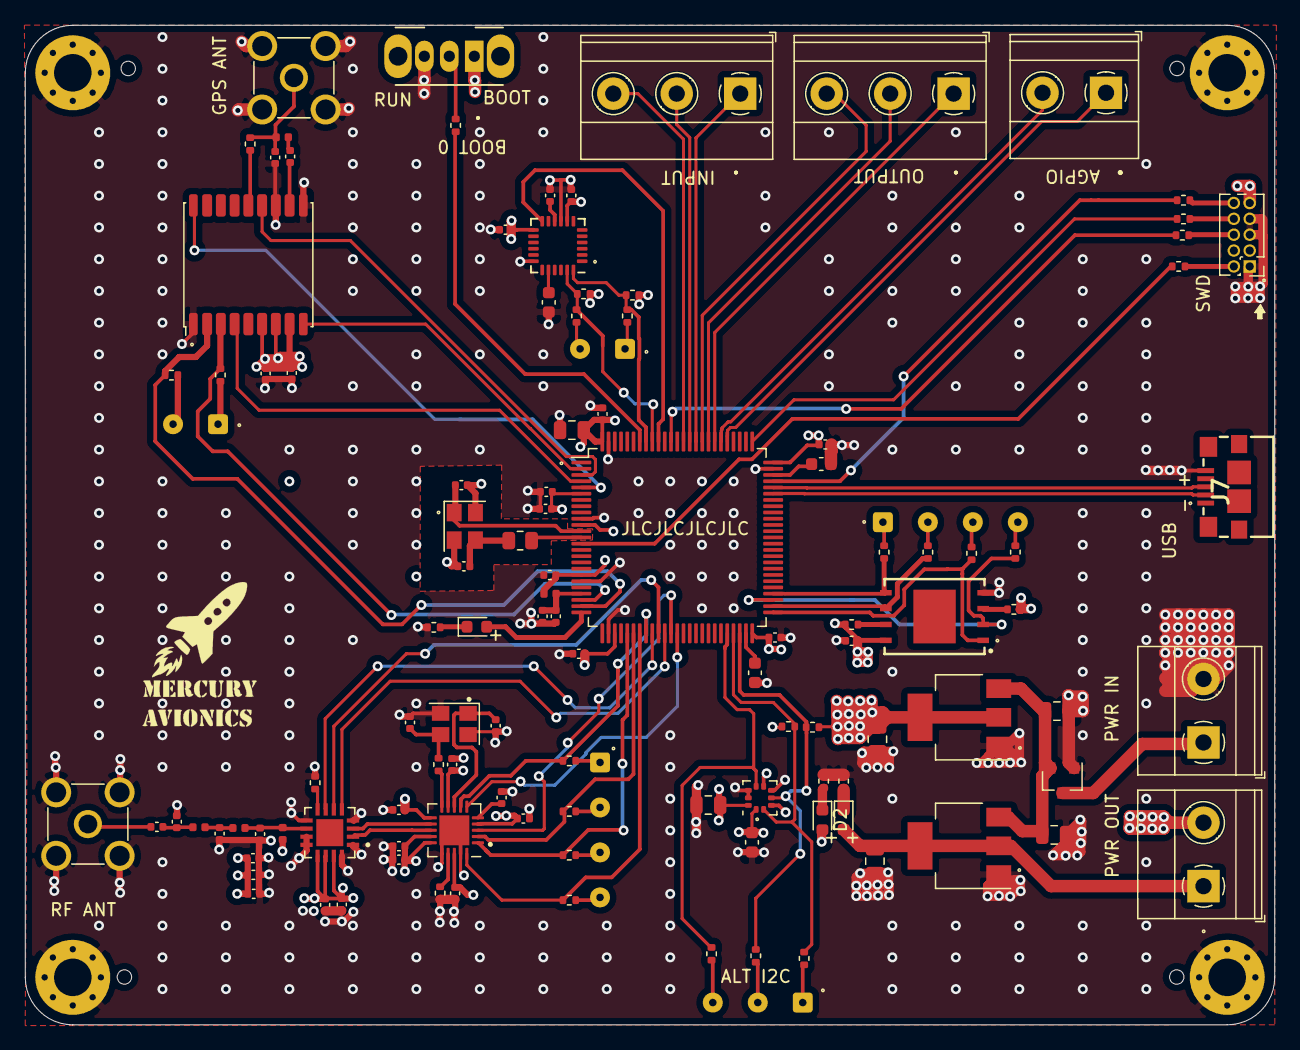
[picture p6: board Mercury.kicad_pcb from above]

Board: 4 copper layers, 100.0 x 80.0 mm, 121 parts (0 on the bottom side), 95 nets.

Other parts of the board:
G1: LOGO
