Mercury-Avionics/Mercury/hardware/STM32/STM32.ioc

Mcu.UserName=STM32F407VGTx
PA0-WKUP.Signal=UART4_TX
PA1.Signal=UART4_RX
PA11.Signal=USB_OTG_FS_DM
PA12.Signal=USB_OTG_FS_DP
PA13.Signal=SYS_JTMS-SWDIO
PA14.Signal=SYS_JTCK-SWCLK
PA2.Signal=GPIO_Output
PA5.Signal=SPI1_SCK
PA6.Signal=SPI1_MISO
PA7.Signal=SPI1_MOSI
PA8.GPIO_Label=GPS_RESET
PA8.Signal=GPIO_Output
PB0.GPIO_Label=RF_LNA_EN
PB0.Signal=GPIO_Output
PB1.GPIO_Label=RF_PA_EN
PB1.Signal=GPIO_Output
PB10.Signal=I2C2_SCL
PB11.Signal=I2C2_SDA
PB12.GPIO_Label=FLASH_CS
PB12.Signal=GPIO_Output
PB13.Signal=SPI2_SCK
PB14.Signal=SPI2_MISO
PB15.Signal=SPI2_MOSI
PB2.GPIO_Label=RF_GPO1
PB2.Signal=GPIO_Input
PB3.Signal=SYS_JTDO-SWO
PB5.GPIO_Label=IMU_INT
PB5.Signal=GPIO_Input
PB6.Signal=I2C1_SCL
PB7.Signal=I2C1_SDA
PC12.GPIO_Label=AGPIO2
PC12.Signal=GPIO_Analog
PC4.GPIO_Label=RF_CS
PC4.Signal=GPIO_Output
PC5.GPIO_Label=RF_HGM
PC5.Signal=GPIO_Output
PC7.GPIO_Label=GPS_SAFEBOOT
PC7.Signal=GPIO_Output
PC8.GPIO_Label=LNA_EN
PC8.Signal=GPIO_Output
PC9.GPIO_Label=TIME_PULSE
PC9.Signal=GPIO_Input
PD0.GPIO_Label=AGPIO1
PD0.Signal=GPIO_Analog
PD1.GPIO_Label=Output3
PD1.Signal=GPIO_Output
PD2.GPIO_Label=Output2
PD2.Signal=GPIO_Output
PD3.GPIO_Label=Output1
PD3.Signal=GPIO_Output
PD4.GPIO_Label=Input3
PD4.Signal=GPIO_Input
PD5.GPIO_Label=Input2
PD5.Signal=GPIO_Input
PD6.GPIO_Label=Input1
PD6.Signal=GPIO_Input
PE14.GPIO_Label=ALT_INT_2
PE14.Signal=GPIO_Output
PE15.GPIO_Label=ALT_INT_1
PE15.Signal=GPIO_Output
PE7.GPIO_Label=RF_GPO0
PE7.Signal=GPIO_Input
PH0-OSC_IN.Signal=RCC_OSC_IN
PH1-OSC_OUT.Signal=RCC_OSC_OUT
