Mercury-Avionics/Mercury/(commit log)

2021-01-06 Layout Done
    [LPS25HBTR.step, Mercury.kicad_pcb, Mercury.sch, User Library-MAX-M8 u-blox M8 Concurrent GNSS Module.step, User Library-sma.step, peripherals.sch]
2021-01-06 Added USB
    [Mercury.kicad_pcb, Mercury.sch]
2021-01-08 Layout + Routing v1 done
    [Mercury.kicad_pcb, Mercury.sch, Parts-Pricelist.xlsx, Parts.xlsx, Parts_not_on_JLC_PCB_LCSC.xlsx, Selected ICs.xlsx, peripherals.sch]
2021-01-12 Updated with final board design
    [Mercury.kicad_pcb, Mercury.sch, peripherals.sch]
2021-01-18 Sent For Manufacture
    [Mercury-B_Cu.gbr, Mercury-B_Mask.gbr, Mercury-B_Paste.gbr, Mercury-B_SilkS.gbr, Mercury-Edge_Cuts.gbr, Mercury-F_Cu.gbr, Mercury-F_Mask.gbr, Mercury-F_Paste.gbr]
